marzoul/TacticalIO-hw/Datasheet/IC/236079027AD9854_RevE_BOM_Pb_Free.xls

AD9854 REV. E-(1.0) EVALUATION BOARD Pb-Free BILL OF MATERIALS 3/01/07
ITEM | QTY | REFDES | DEVICE | PACKAGE | VALUE | MIN TOL | MFR | MFR P/N | VENDOR / DIST | P/N | COMMENTS | Pb-FREE? | BOARD ASSEMBLER Temporary Waiver
1 | 3 | C1, C2, C45 | CAP0805 | 0603 | .01UF, 50V, X7R | 10% | KEMET | C0805C103K5RACTU |  |  | Any Pb-Free Mfr OK | Mfr info states Yes
2 | 21 | C7, C8, C9, C10, C11, | CAP0603 | 0603 | 0.1 UF, 50V, X7R | 10% | Murata | GRM188R71H104KA93D |  |  | Any Pb-Free Mfr OK | Mfr info states Yes
 |  | C12, C13, C14, C16
 |  | C17, C18, C19, C20,
 |  | C22, C23, C24, C26,
 |  | C27, C28, C29, C44
3 | 2 | C4, C37 | CAP1206 | 1206 | 27pF, 50V, NPO | 5%, | YAGEO | CC1206JRNPO9BN270 |  |  | Any Pb-Free Mfr OK | Mfr info states Yes
4 | 2 | C5, C38 | CAP1206 | 1206 | 47pF, 50V, NPO | 5% | YAGEO | CC1206JRNPO9BN470 | Digi-Key | 311-1158-1-ND | Any Pb-Free Mfr OK, If ordering from Digi-Key use vendor part # | Mfr info states Yes
5 | 3 | C6, C21, C25 | CAP TAJC | TAJC | 10uF, 16V, TAJ | 10% | AVX | TAJC106K016R |  |  | Any Pb-Free Mfr OK | Mfr info states Yes
6 | 2 | C30, C39 | CAP1206 | 1206 | 39pF, 50 V, NPO | 5% | YAGEO | CC1206JRNPO9BN390 |  |  | Any Pb-Free Mfr OK | Mfr info states Yes
7 | 2 | C31, C40 | CAP1206 | 1206 | 22 pF, 50V, NPO | 5% | YAGEO | CC1206JRNPO9BN220 |  |  | Any Pb-Free Mfr OK | Mfr info states Yes
8 | 2 | C32, C41 | CAP1206 | 1206 | 2.2 pF, 50 V, NPO | 0.25 pF | YAGEO | CC1206CRNPO9BN2R2 |  |  | Any Pb-Free Mfr OK | Mfr info states Yes
9 | 2 | C33, C42 | CAP1206 | 1206 | 12 pF, 50 V, NPO | 5% | YAGEO | 1206CG120J9B200 |  |  | Any Pb-Free Mfr OK | Mfr info states Yes
10 | 2 | C34, C43 | CAP1206 | 1206 | 8.2 pF, 50V, NPO | 0.5 pF | YAGEO | CC1206DRNPO9BN8R2 |  |  | Any Pb-Free Mfr OK | Mfr info states Yes
11 | 9 | J1, J2, J3, J4, J5 | SMB | STR-PC MNT | N/A | N/A | Emerson/Johnson | 131-3701-261 |  |  |  | Mfr info states Yes
 |  | J6, J7, J25, J26
12 | 1 | J10 | 40PINHEADER | HEADER40 | N/A | N/A | SAMTEC | TSW-120-23-L-D |  |  |  | Mfr info states Yes
13 | 4 | L1, L2, L3, L5 | IND-COIL | 1008CS | 68nH | 2% | COILCRAFT | 1008CS-680XGLB |  |  |  | Mfr info states Yes
14 | 2 | L4, L6 | IND-COIL | 1008CS | 82nH | 2% | COILCRAFT | 1008CS-820XGLB |  |  |  | Mfr info states Yes
15 | 2 | R1, R5 | RES_SM | 1206 | 49.9, 1/4W | 1% | Panasonic-ECG | ERJ-8ENF49R9V |  |  | Any Pb-Free Mfr OK | Mfr info states Yes
16 | 2 | R2, R20 | RES_SM | 1206 | 3.92 K Ohm, 1/4 W | 1% | Panasonic-ECG | ERJ-8ENF3921V |  |  | Any Pb-Free Mfr OK | Mfr info states Yes
17 | 2 | R3, R7 | RES_SM | 1206 | 24.9 Ohm, 1/4 W | 1% | Panasonic-ECG | ERJ-8ENF24R9 |  |  | Any Pb-Free Mfr OK | Mfr info states Yes
18 | 1 | R4 | RES_SM | 1206 | 1.3K Ohm, 1/4 W | 1% | Panasonic-ECG | ERJ-8ENF1301V |  |  | Any Pb-Free Mfr OK | Mfr info states Yes
19 | 4 | R6, R11, R12, R13 | RES_SM | 1206 | 49.9, 1/4W | 1% | Panasonic-ECG | ERJ-8ENF49R9V |  |  | Any Pb-Free Mfr OK | Mfr info states Yes
20 | 1 | R8 | RES_SM | 1206 | 2 K Ohm, 1/4 W | 1% | Panasonic-ECG | ERJ-8ENF2001V |  |  | Any Pb-Free Mfr OK | Mfr info states Yes
21 | 2 | R9, R10 | RES_SM | 1206 | 100 Ohm, 1/4 W | 1% | Panasonic-ECG | ERJ-8ENF1000V |  |  | Any Pb-Free Mfr OK | Mfr info states Yes
22 | 4 | R15, R16, R17, R18 | RES_SM | 1206 | 10 K Ohm, 1/4 W | 1% | Panasonic-ECG | ERJ-8ENF1002V |  |  | Any Pb-Free Mfr OK | Mfr info states Yes
23 | 1 | RP1 | RES NETWORK | SIP-10P | 10K Ohm | 2% | Bourns | 4610X-101-103LF |  |  |  | Mfr info states Yes
24 | 1 | TB1 | TB4 | 4 Position Terminal | N/A | N/A | Wieland | Plug: 25.602.2453.0 |  |  | Order Plug & Term Strip (2 items) | Mfr info states Yes
 |  |  |  |  |  |  |  | Terminal Strip: Z5.530.3425.0 |  |  |  | Mfr info states Yes
25 | 1 | U1 | AD9854 | SV-80 | N/A | N/A | Analog Devices, Inc. | AD9854ASVZ |  |  |  | Mfr info states Yes
26 | 1 | U2 | 74HC125D | 14 SOIC | N/A | N/A | Texas Instruments | SN74HC125DR |  |  |  | Mfr info states Yes
27 | 1 | U3 | Primary: |  |  |  |  | Primary:
 |  |  | MC10EP16DGOS | 8 SOIC | N/A | N/A | ON Semiconductor | MC10EP16DG |  |  |  | Mfr info states Yes
 |  |  | Secondary: |  |  |  |  | Secondary:
 |  |  | MC100LVEL16DGOS | 8 SOIC | N/A | N/A | ON Semiconductor | MC100LVEL16DG |  |  |  | Mfr info states Yes
28 | 4 | U4, U5, U6, U7 | 74HC14 | 14 SOIC | N/A | N/A | Texas Instruments | SN74HC14DR |  |  |  | Mfr info states Yes
29 | 3 | U8, U9, U10 | 74HC574 | 20 SOIC | N/A | N/A | Texas Instruments | SN74HC574DWR |  |  |  | Mfr info states Yes
30 | 1 | J11 | C36CRPX | 36CRP | N/A | N/A | TYCO Electronics | 5552742-1 |  |  |  | Mfr info states Yes
31 | 6 | W1, W2, W3, W4 | 3PINHDR | SIP-3P | N/A | N/A | Samtec | TSW-103-07-S-S |  |  |  | Mfr info states Yes
 |  | W8, W17
32 | 10 | W6, W7, W9, W10, | 2PINHDR | SIP-2P | N/A | N/A | Samtec | TSW-102-07-S-S |  |  |  | Mfr info states Yes
 |  | W11, W12, W13, W14,
 |  | W15, W16
33 | 6 | W1, W2, W3, W4 | Jumpers | N/A | Black | N/A | Samtec | SNT-100-BK-G |  |  | Install on pins 1 & 2 of W1, W4; pins 2 & 3 of W2, W8, W3, W17 | Mfr info states Yes
 |  | W8, W17
34 | 10 | W6, W7, W9, W10, | Jumpers | N/A | Black | N/A | Samtec | SNT-100-BK-G |  |  | Install on W6, W7, W9, W10, W11, W12, W13, W14, W15, W16 | Mfr info states Yes
 |  | W11, W12, W13, W14,
 |  | W15, W16
35 | 2 | N/A | SELF-TAPPING | 4-40, PHILLIPS | N/A | N/A |  | 90410A107 | McMASTER-CARR |  | Any Pb-Free Mfr OK, Install on J11 | Mfr info states Yes
 |  |  | SCREW | PAN HEAD
36 | 4 | N/A | Adhesive Feet | N/A | Black | N/A | 3M | SJ-5518 | Digi-Key | SJ5518-0-ND | Install on Bottom, 4 Corners, One in PC Board Center | Mfr info states Yes
37 | 1 | N/A | AD9852/54 PCBZ | N/A | N/A | N/A | Moog Components Grp. | GS02669 REV. E |  |  |  | Mfr info states Yes
38 | 2 | R14, R19 | RES_SM | 1206 | 0, 1/4 W | 5% | Panasonic-ECG | ERJ-8GEY0R00V |  |  | Any Pb-Free Mfr OK | Mfr info states Yes
39 | 4 | N/A | Pin Socket (Open End) |  |  |  | Tyco Electronics | 5-5330808-6 |  |  | Installed at "Optional Crystal Oscillator" Silkscreen | Mfr info states Yes
40 | 1 | Y1 | XTAL | COSC | N/A | N/A | OPTIONAL | OPTIONAL |  |  | Installed by customer as needed
