marzoul/TacticalIO-hw/logo/logo_tio.dxf

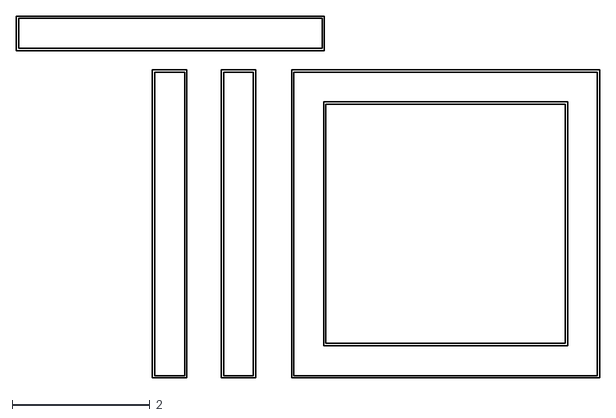
[picture p4: CAD file, 2015-01-09]
logo/logo_tio.dxf
8.48 x 5.26
