marzoul/TacticalIO-hw/PCB/Template/logo_opentekhnia_2014_notext_portable.dxf

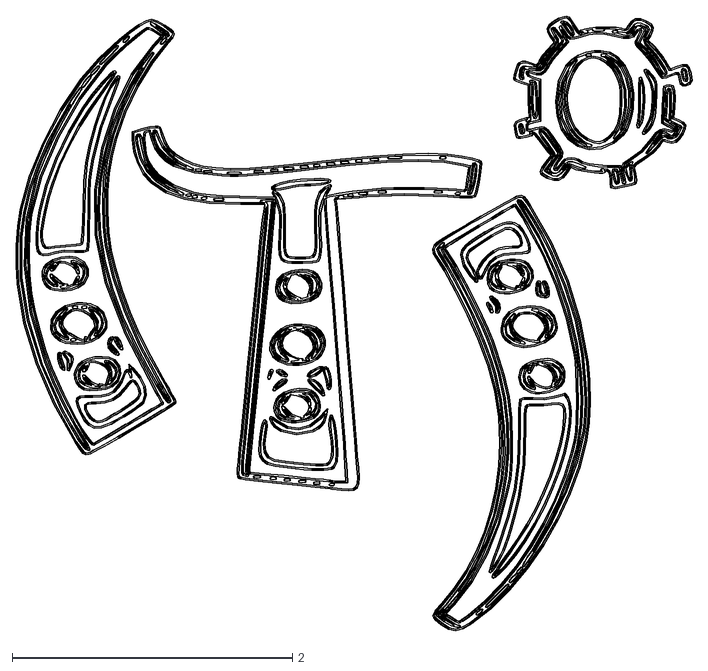
[picture p5: CAD file, 2015-01-09]
PCB/Template/logo_opentekhnia_2014_notext_portable.dxf
4.83 x 4.39
