marzoul/TacticalIO-hw/PCB/Template/RoHS.dxf

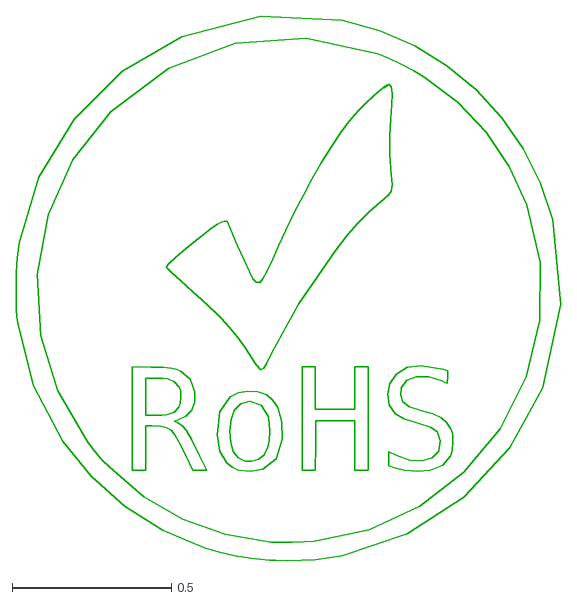
[picture p6: CAD file, 2015-01-09]
PCB/Template/RoHS.dxf
1.71 x 1.71
