marzoul/TacticalIO-hw/PCB/Boards/GPIO64/TIO-64GPIO (PCB - Forward Design Changes Report).txt

Forward Design Changes Report
-----------------------------

Report File    : E:\Users\Alex\Documents\tio-64gpio\PCB\TIO-64GPIO_REV1_03\TIO-64GPIO (PCB - Forward Design Changes Report).txt
Report Written : Friday, December 19, 2014
Project Path   : E:\Users\Alex\Documents\tio-64gpio\PCB\TIO-64GPIO_REV1_03\TIO-64GPIO_REV1_03.prj
Design Path    : E:\Users\Alex\Documents\tio-64gpio\PCB\TIO-64GPIO_REV1_03\TIO-64GPIO.pcb
Design Title   : 
Created        : 9/17/2014 7:53:59 PM
Last Saved     : 12/19/2014 10:14:44 AM
Editing Time   : 11826 min
Units          : mm (precision 1)

Disconnected pin "R12-2" from net "+5V".
Disconnected pin "R13-2" from net "+5V".
Disconnected pin "R14-2" from net "+5V".
Disconnected pin "R15-2" from net "+5V".
Disconnected pin "R24-2" from net "+5V".
Disconnected pin "R25-2" from net "+5V".
Disconnected pin "R26-2" from net "+5V".
Disconnected pin "R27-2" from net "+5V".
Disconnected pin "R36-2" from net "+5V".
Disconnected pin "R37-2" from net "+5V".
Disconnected pin "R38-2" from net "+5V".
Disconnected pin "R39-2" from net "+5V".
Disconnected pin "R48-2" from net "+5V".
Disconnected pin "R49-2" from net "+5V".
Disconnected pin "R50-2" from net "+5V".
Disconnected pin "R51-2" from net "+5V".
Disconnected pin "R89-1" from net "+5V".
Disconnected pin "R90-1" from net "+5V".
Disconnected pin "R91-1" from net "+5V".
Disconnected pin "R92-1" from net "+5V".
Disconnected pin "R93-1" from net "+5V".
Disconnected pin "R94-1" from net "+5V".
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
Connected pin "C4-2" to net "+3.3V".
Connected pin "U45-1" to net "GND".
Connected pin "U45-2" to net "+3.3V".
Connected pin "U45-3" to net "+5V".
Connected pin "U45-4" to net "GND".
Connected pin "C39-1" to net "GND".
Connected pin "C39-2" to net "+3.3V".

End Of Report.
