marzoul/TacticalIO-hw/PCB/Boards/GPIO/GPIO - PCB.pdf

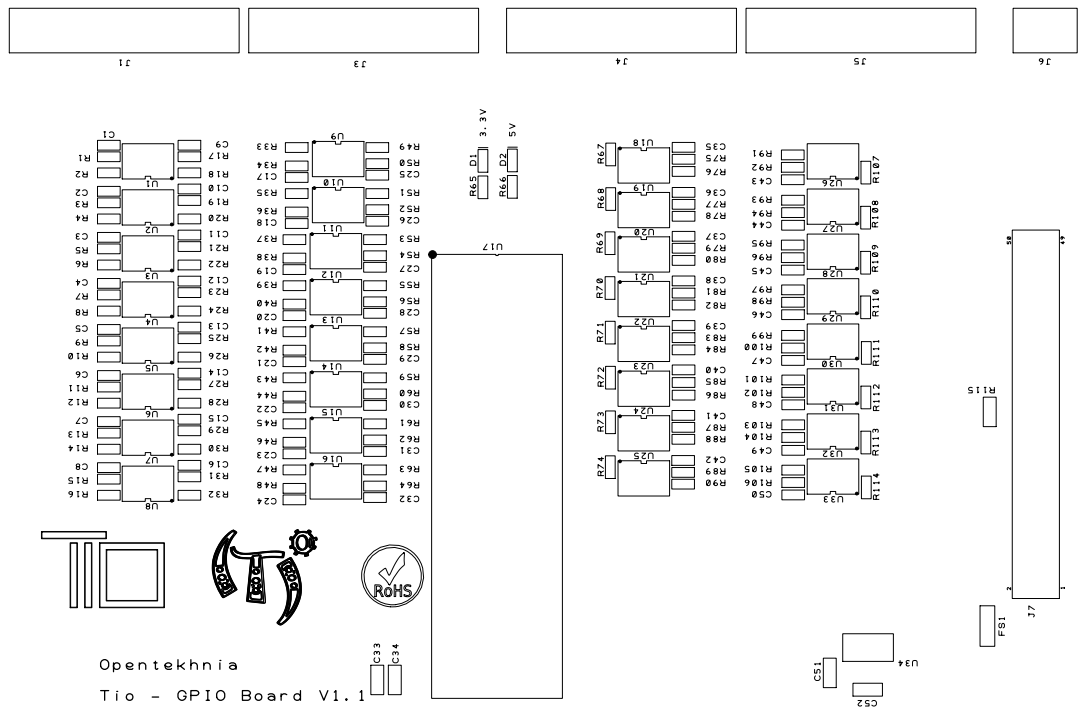
[picture p23: page 1]

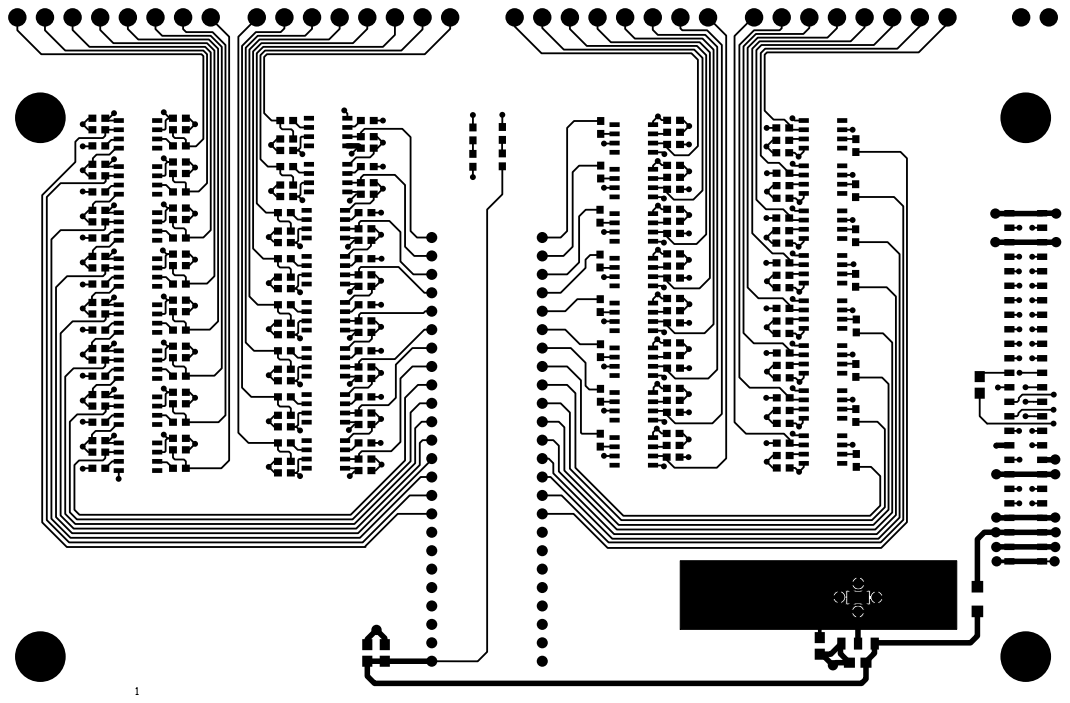
[picture p24: page 2]

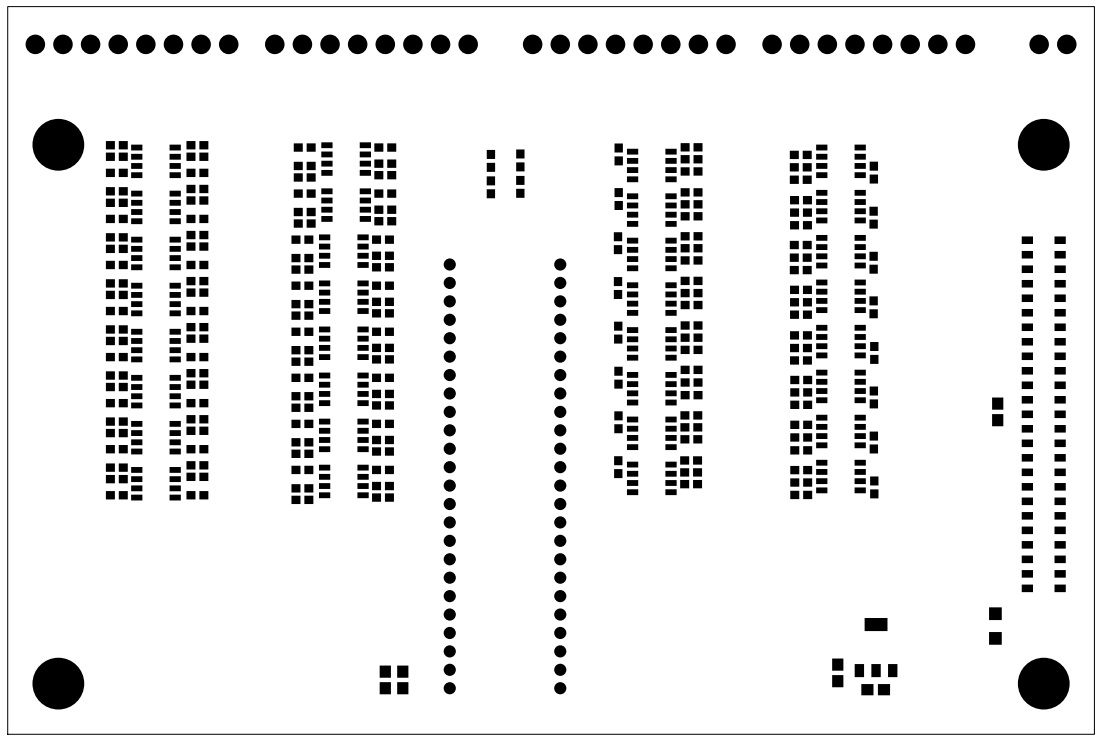
[picture p25: page 3]

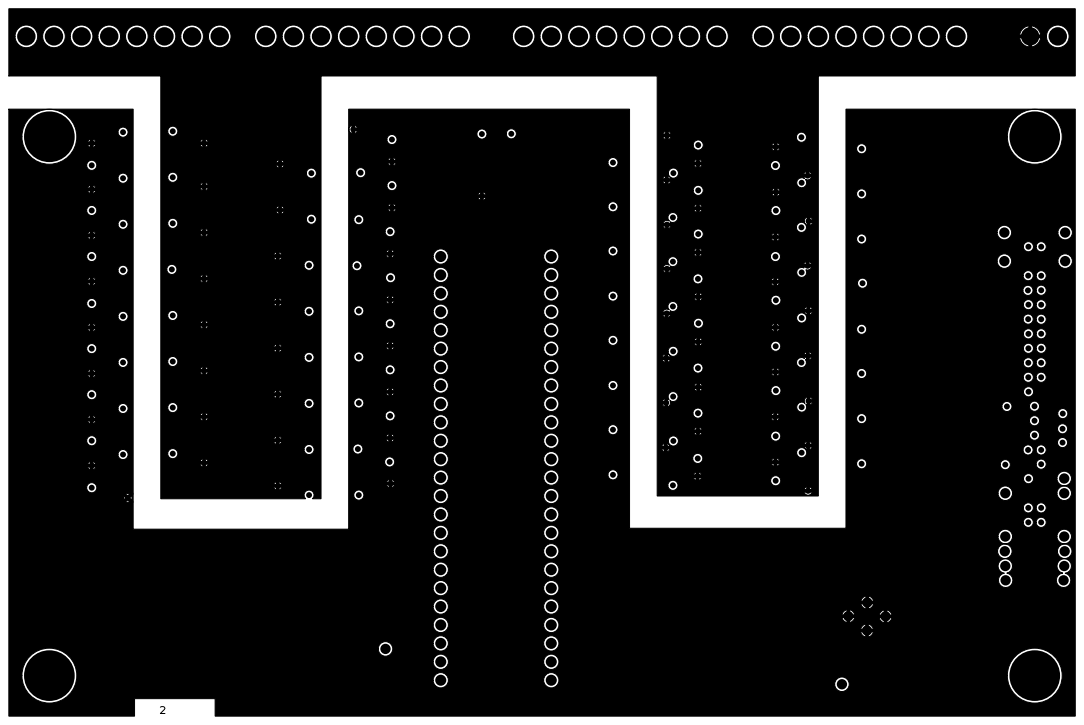
[picture p26: page 5]

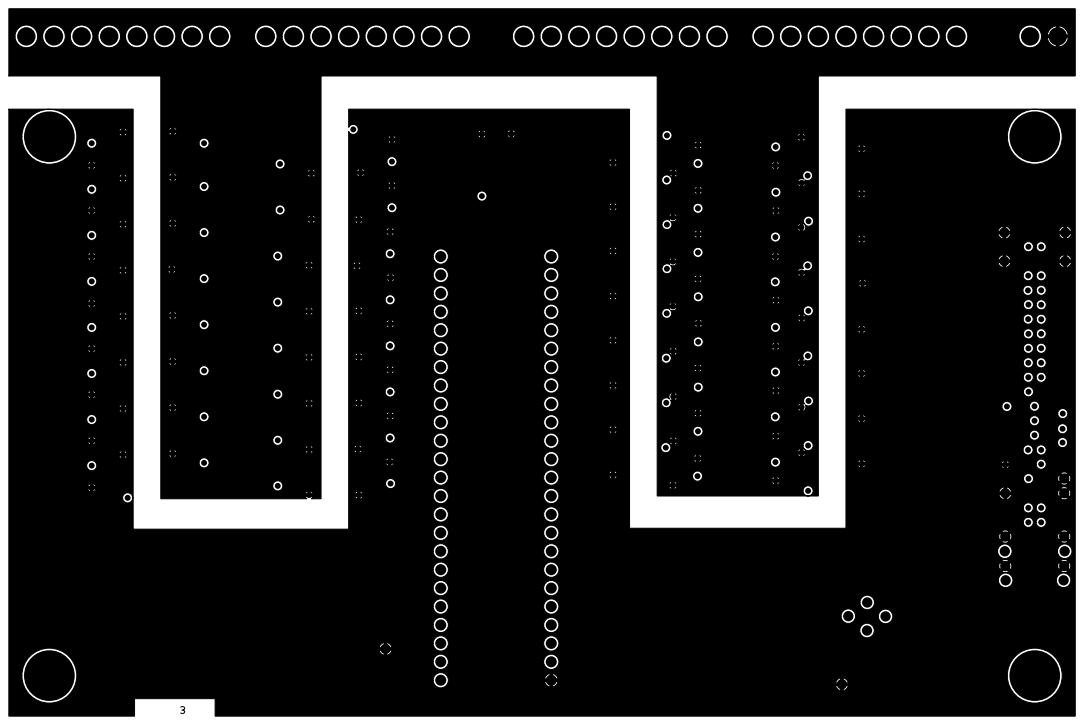
[picture p27: page 6]

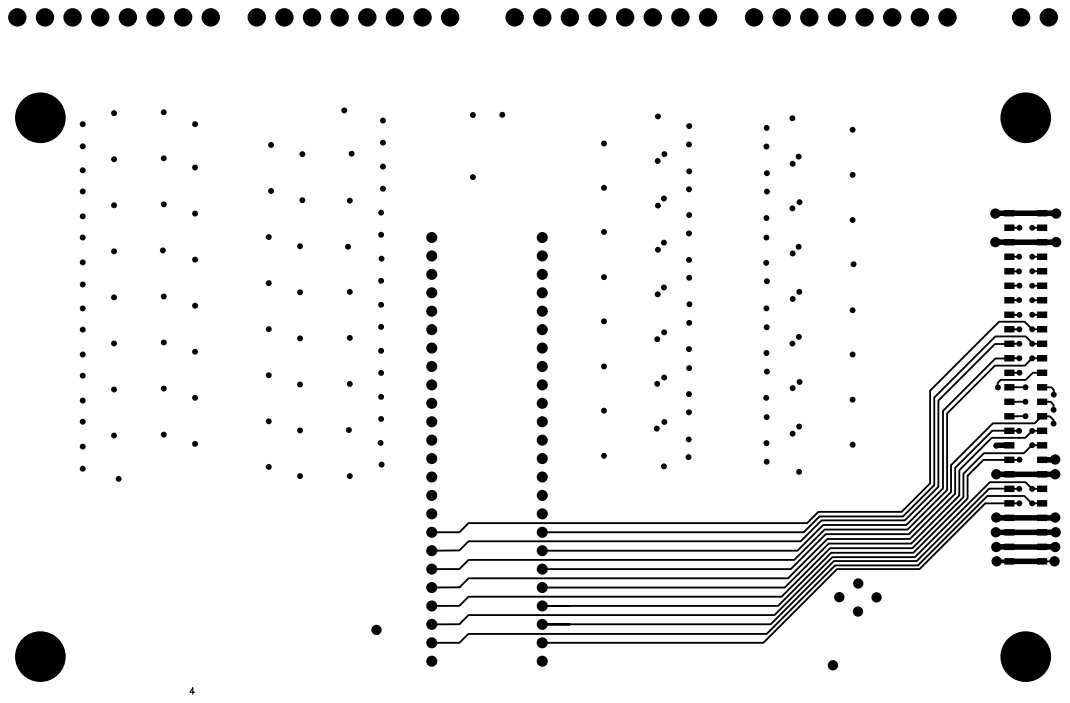
[picture p28: page 7]

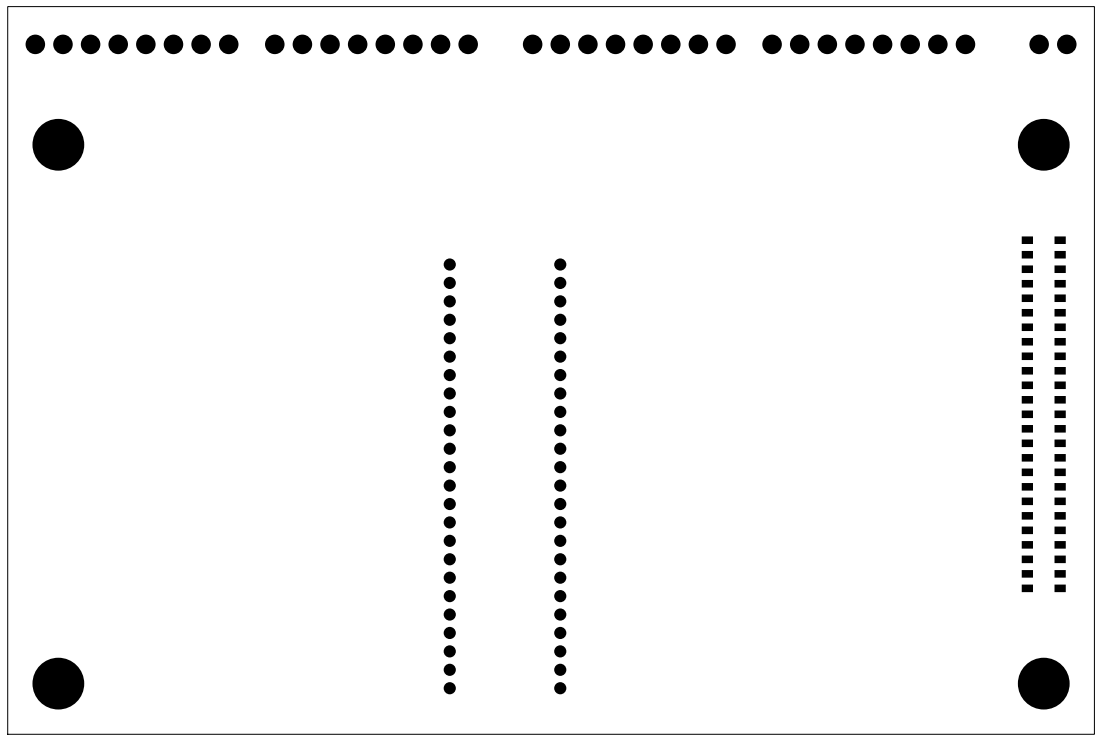
[picture p29: page 9]

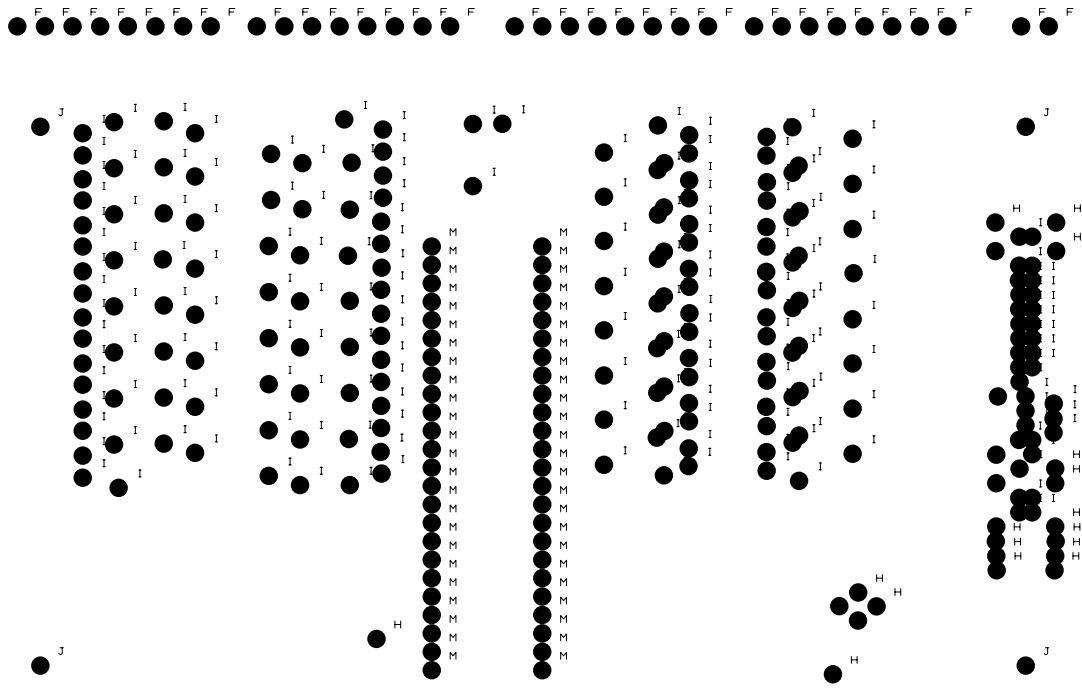
[picture p30: page 11]
