marzoul/TacticalIO-hw/(list of files, drawings)

Other design files:
PCB/Boards/AIO/AIO.pcb
PCB/Boards/Cpu/Cpu.pcb
PCB/Boards/FSK-COM/FSK-COM.pcb
PCB/Boards/GPIO64/TIO-64GPIO.pcb
PCB/Boards/GPIO/GPIO.pcb
PCB/Template/Tio template.pcb
