marzoul/TacticalIO-hw/(commit log)

2015-01-09 initial: v1.1.3
    [236079027AD9854_RevE_BOM_Pb_Free.xls, AIN.sch, AIO (Pick&Place).csv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]
2015-02-20 Remove files generated by synthesis
    [Top_pad.csv]
2015-02-27 Fixed FSK-COM Makefile about coregen uart
